henriquefig/ISEP-s-water-supply-management-system/README.md

# ISEP's water supply management system
A project implementing some small circuitry to convert the chosen sensors’ output to a Arduino MEGA that would control the  entire system.
Please refer to “Requirements” and to the “Article” to learn more about the project.
<p align="center">
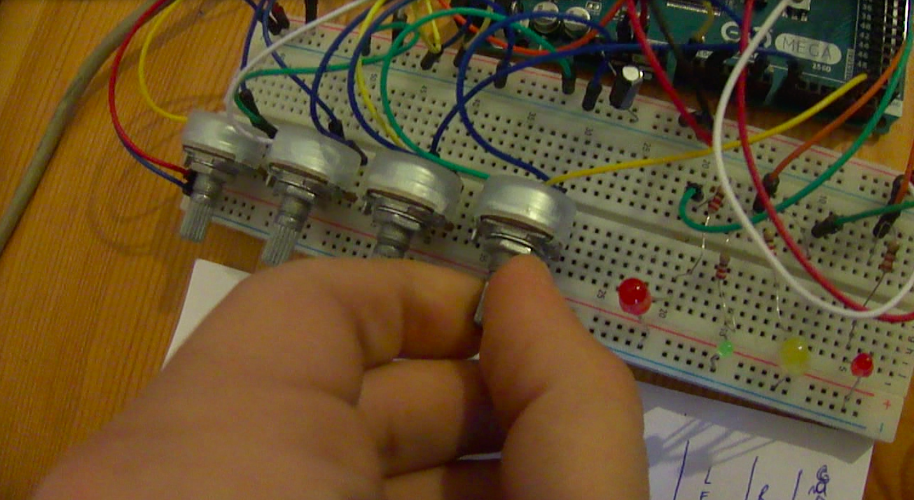
[picture p1: watering.png]
  
</p>
<h2> Demonstrative video</h2>

Watch the video (https://youtu.be/kcr6KDLEy64)
