henriquefig/ISEP-s-water-supply-management-system/Block_diagram.pdf

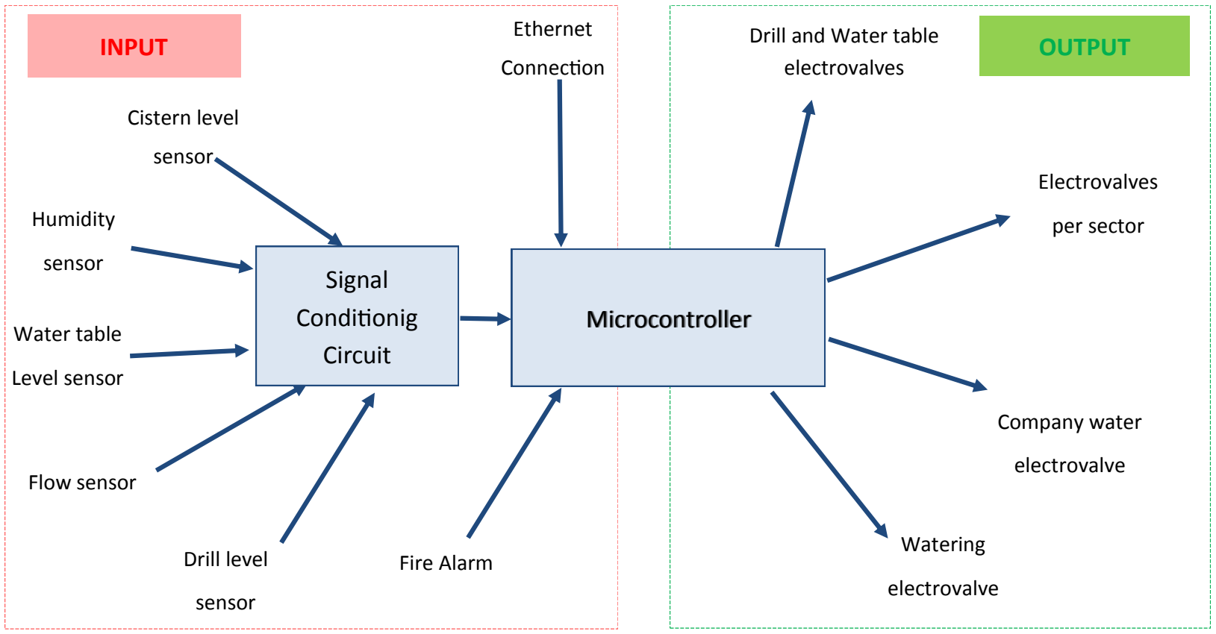
[picture p13: figure]
Microcontroller; INPUT; OUTPUT; Signal Conditionig Circuit; Ethernet; Connection; Cistern level; sensor; Humidity; Water table; Level sensor; Flow sensor; Fire Alarm; Drill and Water table electrovalves; Drill level; Electrovalves; per sector; Company water; electrovalve; Watering
